jomy-tech/Teensy-breakout-board/Teensy_breakout_lores.jpg

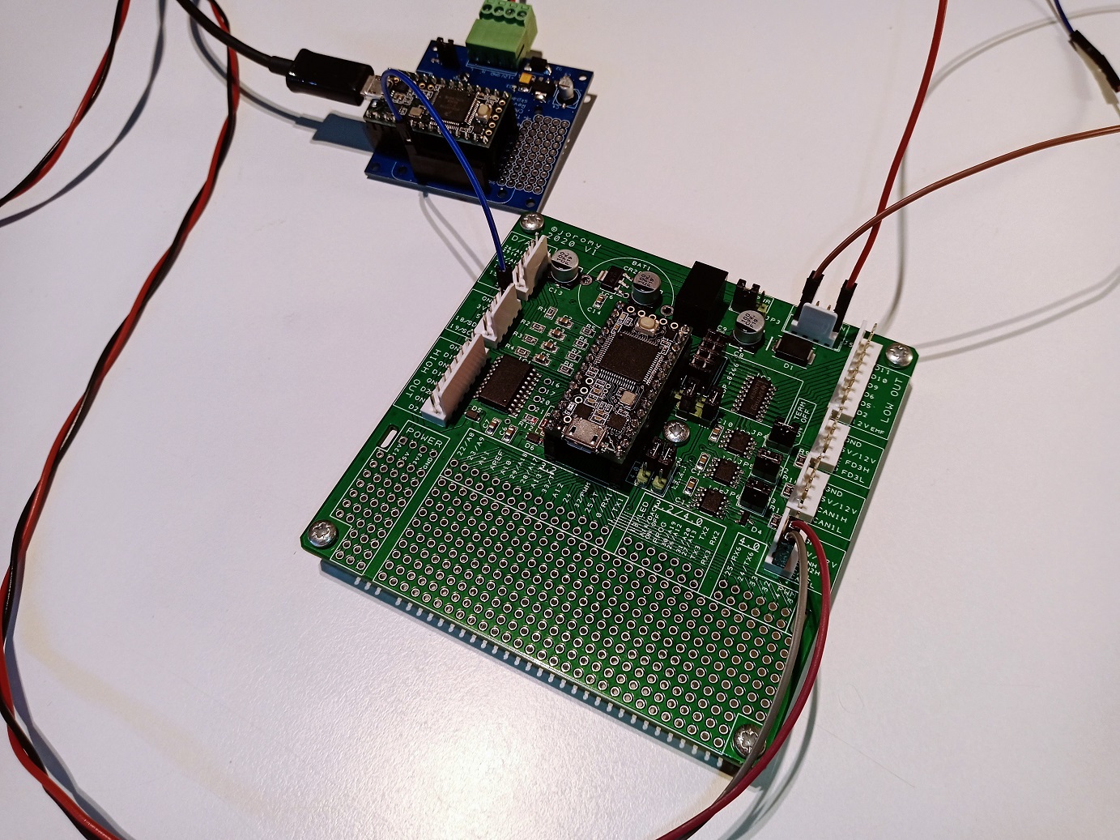
Teensy_breakout_lores.jpg
